MikeGrumbach/Arduino-RV-LED-Light-Controller/steps up to bedroom over LiON Batteries.jpg

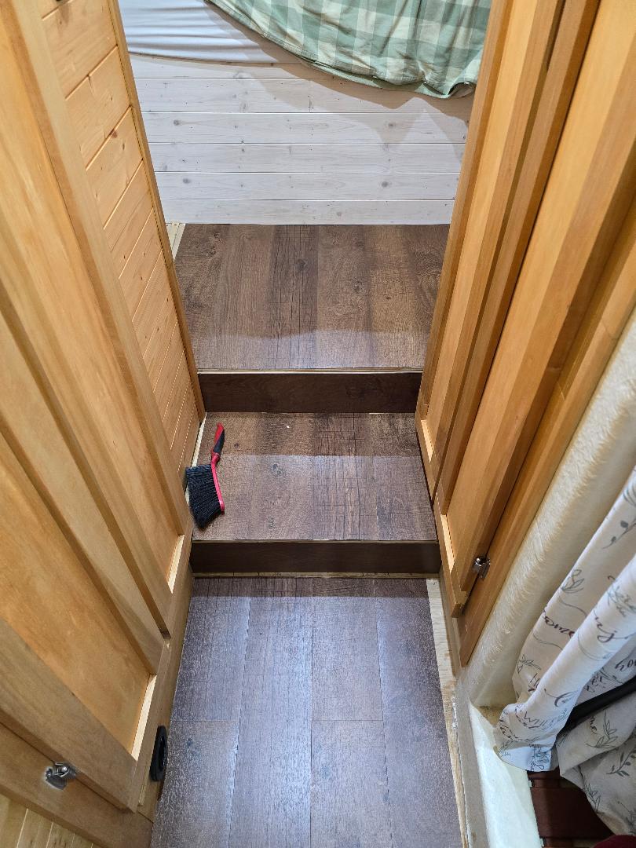
steps up to bedroom over LiON Batteries.jpg
