MikeGrumbach/Arduino-RV-LED-Light-Controller/toilet.jpg

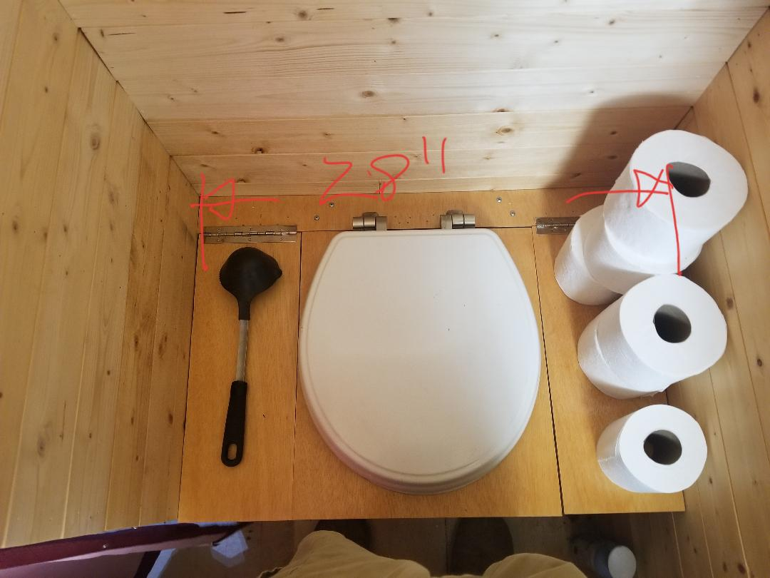
toilet.jpg
