MikeGrumbach/Arduino-RV-LED-Light-Controller/README.md

# Arduino-RV-LED-Light-Controller
This project is used to allow multiple 12v led ceiling lights, wired in parallel, to be turned off/on with a handheld IR controller and/or a wall switch, and Arduino Uno and a small electronic circuit
