MikeGrumbach/Arduino-RV-LED-Light-Controller/Arduino/README.md

**Arduino Code**

This folder contains the Arduino code for the RV LED Light Controller project.
