MikeGrumbach/Arduino-RV-LED-Light-Controller/Documentation/Arduino Software Requirements.pdf

This sketch was developed and tested using Arduino IDE 2.3.7, with the Arduino Uno and IRremote.h library.

If you are using a different version, some commands or functions may not be recognized by the compiler and the sketch may require modifications.

# Arduino Software Requirements

Saturday, September 5, 2026 12:30 PM

Light Switch Page 1
