MikeGrumbach/Arduino-RV-LED-Light-Controller/Resources/Helpful Links.pdf

Some helpful links I used when creating the circuit board
How to Build a Voltage Comparator Circuit with an LM393 (https://www.learningaboutelectronics.com/Articles/LM393-voltage-comparator-circuit.php)

LM358 IC Pin Configuration, Working, LM358 Circuit Examples (https://www.electroniclinic.com/lm358-ic-pin-configuration-working-lm358-circuit-examples/)

Op-amp Comparator Circuit Compares Voltage Levels (https://www.electronics-tutorials.ws/opamp/op-amp-comparator.html)

What is a Diode? A Guide For Beginners (https://www.build-electronic-circuits.com/what-is-a-diode/)

NPN Transistor Tutorial - The Bipolar NPN Transistor (https://www.electronics-tutorials.ws/transistor/tran_2.html)

Transistor as a Switch - Using Transistor Switching (https://www.electronics-tutorials.ws/transistor/tran_4.html)

# Helpful Links

Thursday, December 25, 2025 2:03 PM

Light Switch Page 1
