MikeGrumbach/Arduino-RV-LED-Light-Controller/Skoolie/bathroom and power closet.jpg

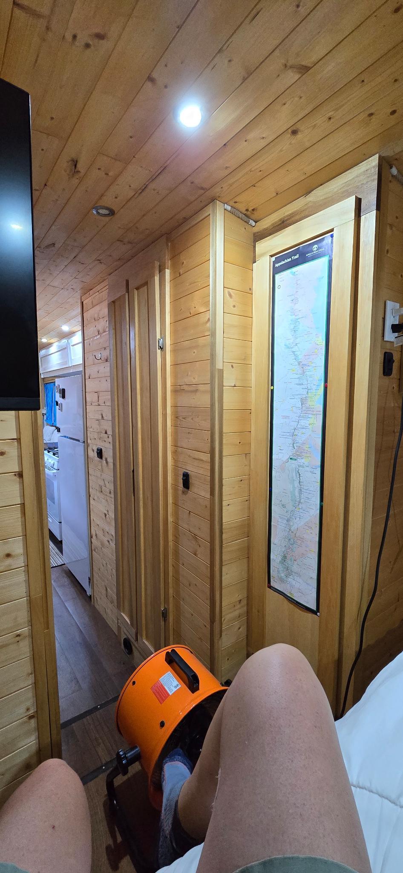
Skoolie/bathroom and power closet.jpg
