MikeGrumbach/Arduino-RV-LED-Light-Controller/Skoolie/bathroom sink.jpg

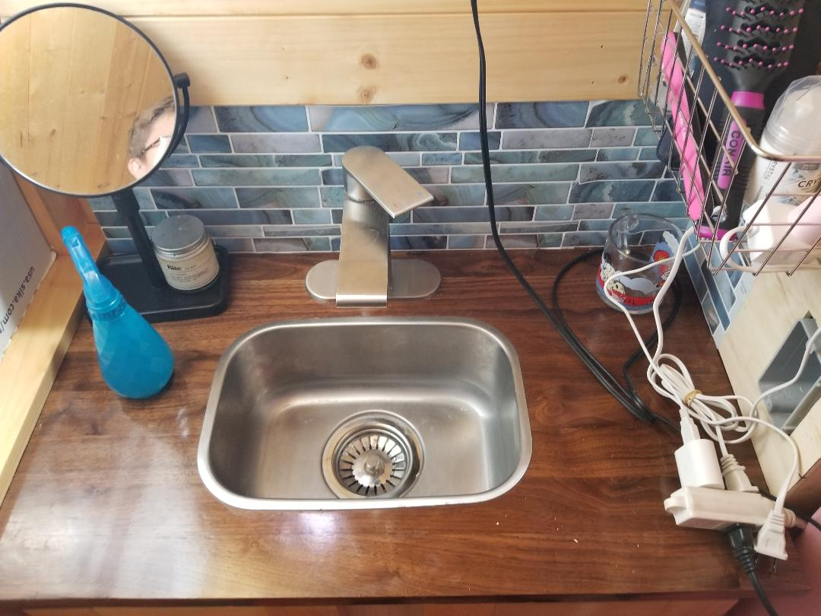
Skoolie/bathroom sink.jpg
