MikeGrumbach/Arduino-RV-LED-Light-Controller/Skoolie/bedroom clothes cabinet.jpg

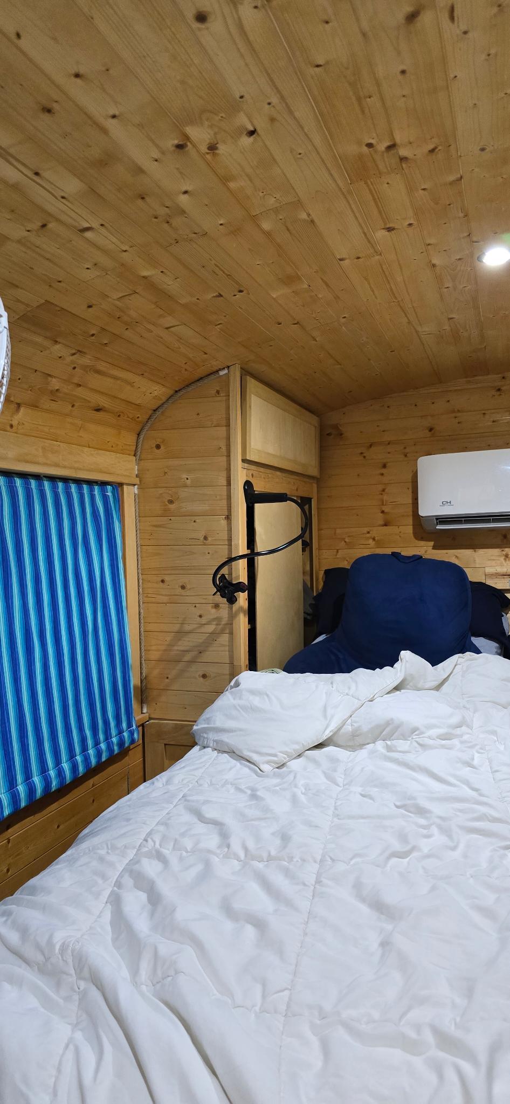
Skoolie/bedroom clothes cabinet.jpg
