MikeGrumbach/Arduino-RV-LED-Light-Controller/Skoolie/bedroom.jpg

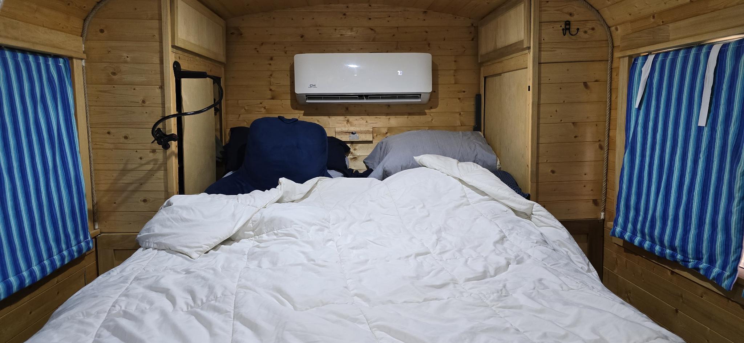
Skoolie/bedroom.jpg
