MikeGrumbach/Arduino-RV-LED-Light-Controller/Skoolie/closet.jpg

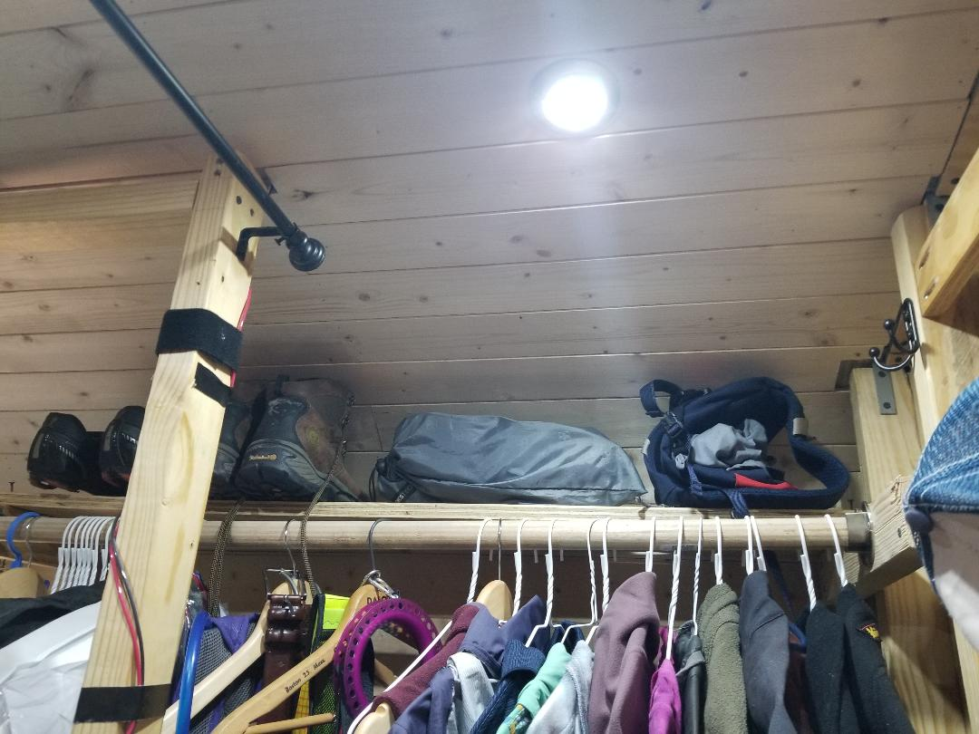
Skoolie/closet.jpg
