MikeGrumbach/Arduino-RV-LED-Light-Controller/Skoolie/collapsible table.jpg

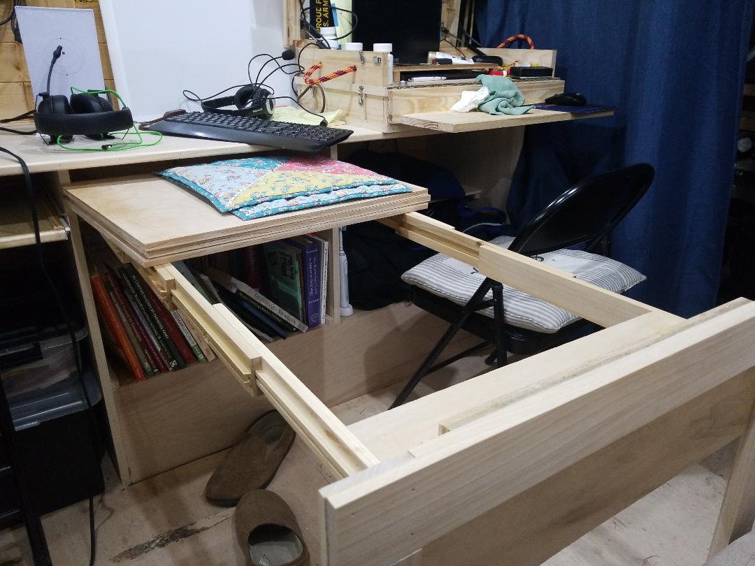
Skoolie/collapsible table.jpg
