MikeGrumbach/Arduino-RV-LED-Light-Controller/Skoolie/couch.jpg

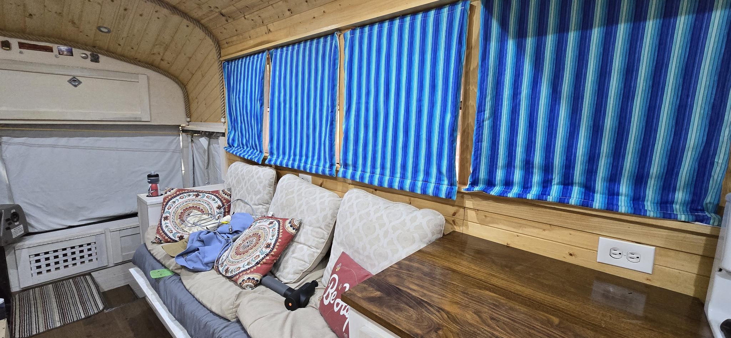
Skoolie/couch.jpg
