MikeGrumbach/Arduino-RV-LED-Light-Controller/Skoolie/flatscreen in bedroom.jpg

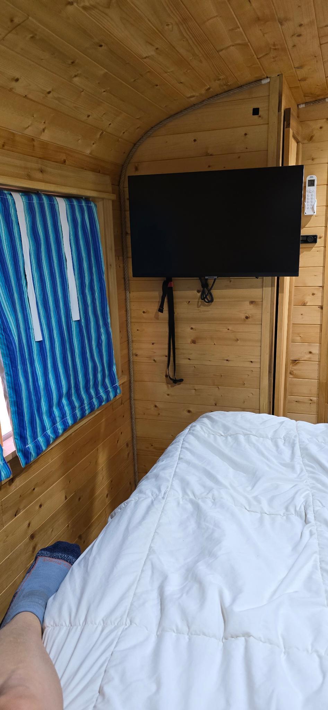
Skoolie/flatscreen in bedroom.jpg
