MikeGrumbach/Arduino-RV-LED-Light-Controller/Skoolie/front area.jpg

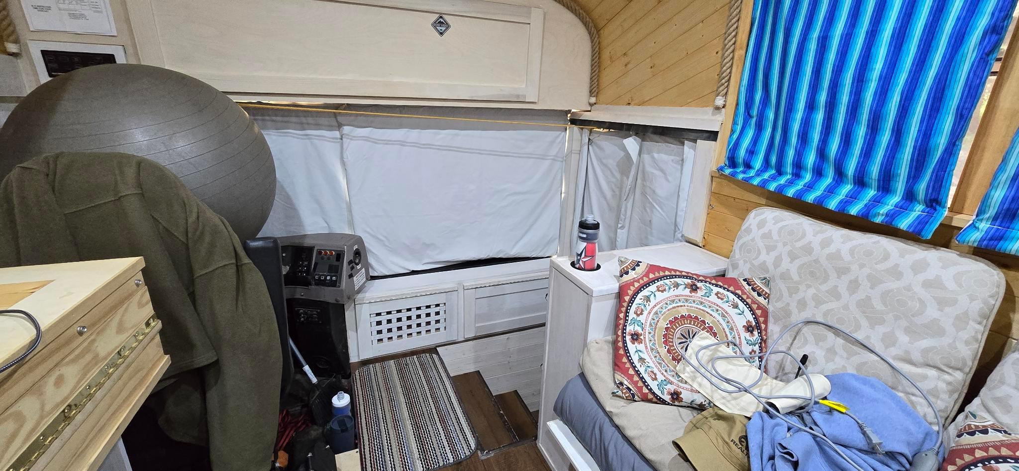
Skoolie/front area.jpg
