MikeGrumbach/Arduino-RV-LED-Light-Controller/Skoolie/front office.jpg

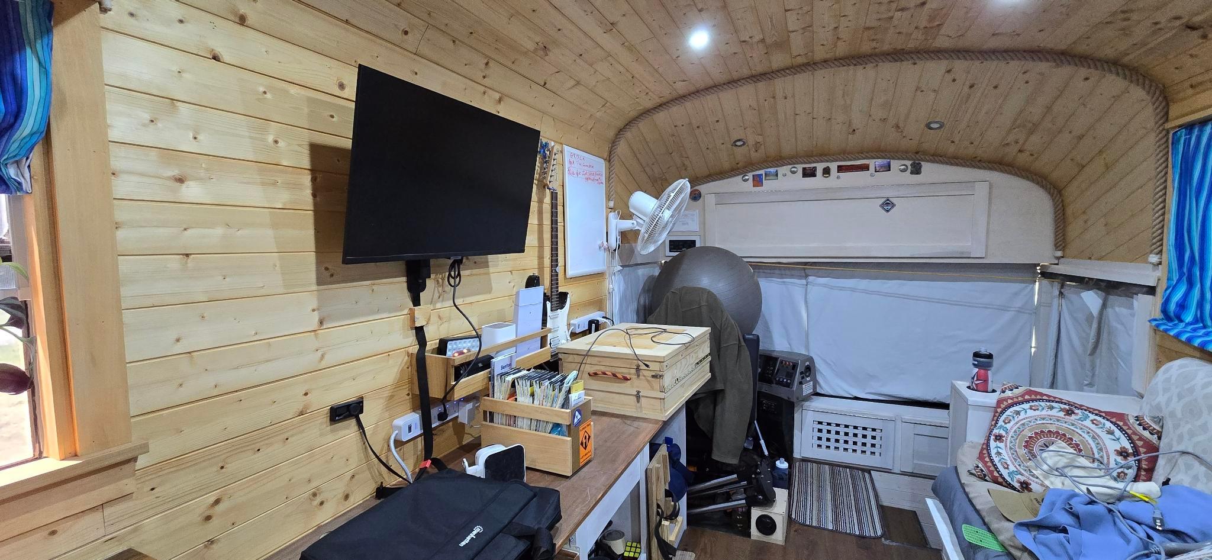
Skoolie/front office.jpg
