MikeGrumbach/Arduino-RV-LED-Light-Controller/Skoolie/galley 2.jpg

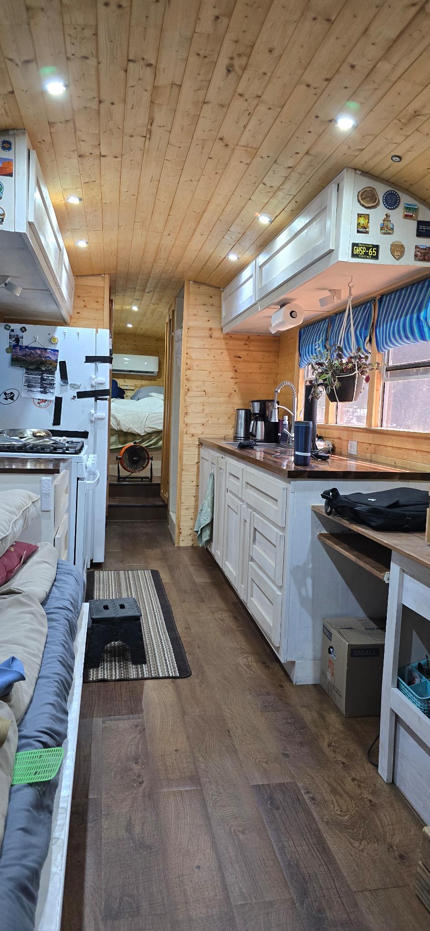
Skoolie/galley 2.jpg
