MikeGrumbach/Arduino-RV-LED-Light-Controller/Skoolie/galley.jpg

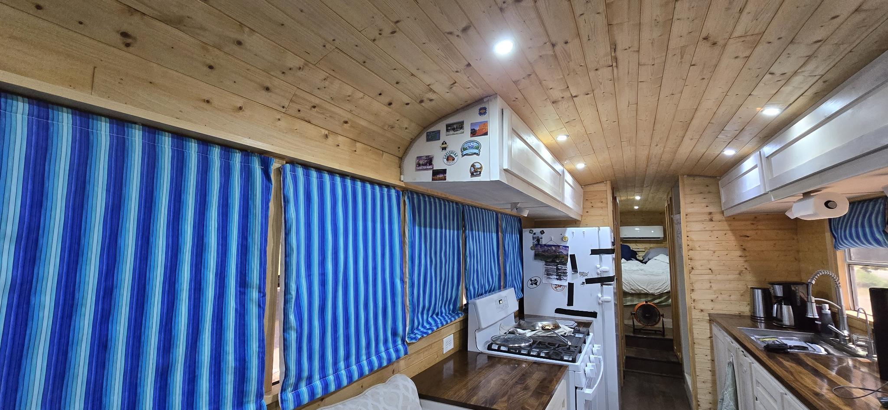
Skoolie/galley.jpg
