MikeGrumbach/Arduino-RV-LED-Light-Controller/Skoolie/kitchen drawers.jpg

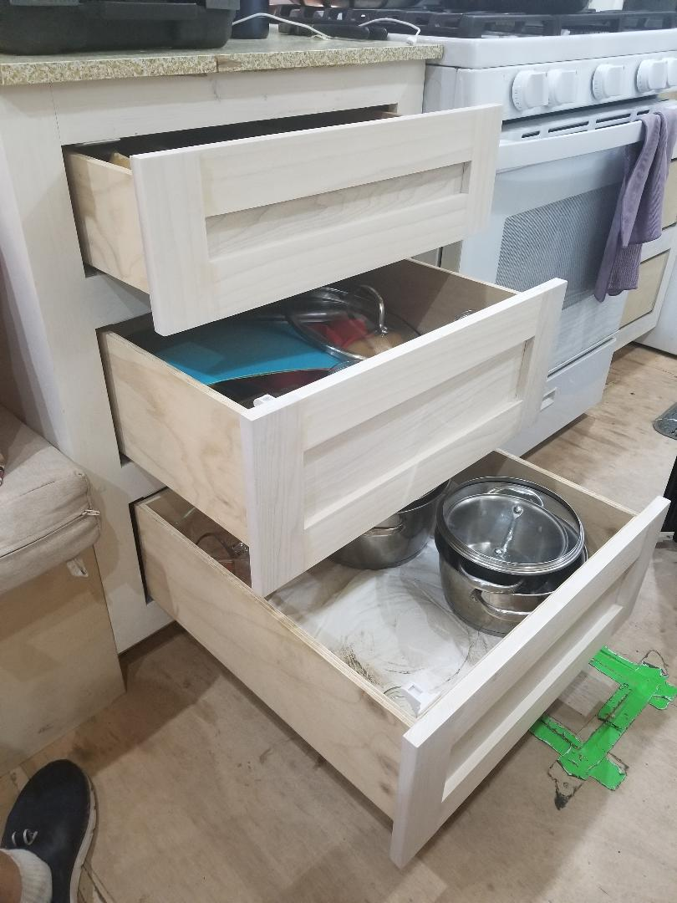
Skoolie/kitchen drawers.jpg
