MikeGrumbach/Arduino-RV-LED-Light-Controller/Skoolie/shower.jpg

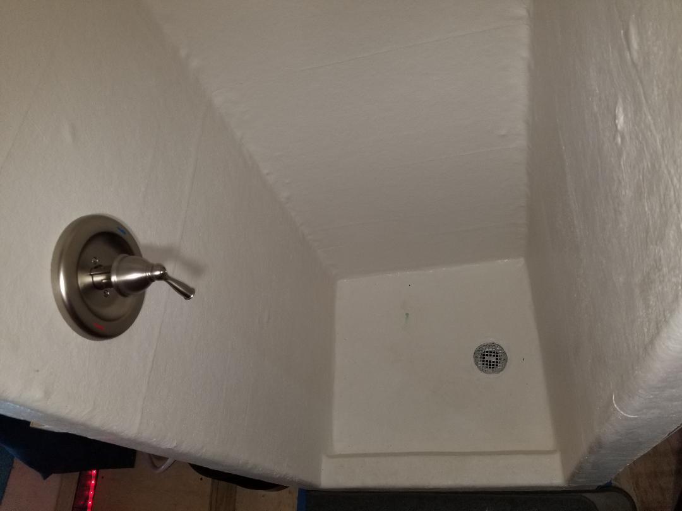
Skoolie/shower.jpg
