MikeGrumbach/Arduino-RV-LED-Light-Controller/starlink.jpg

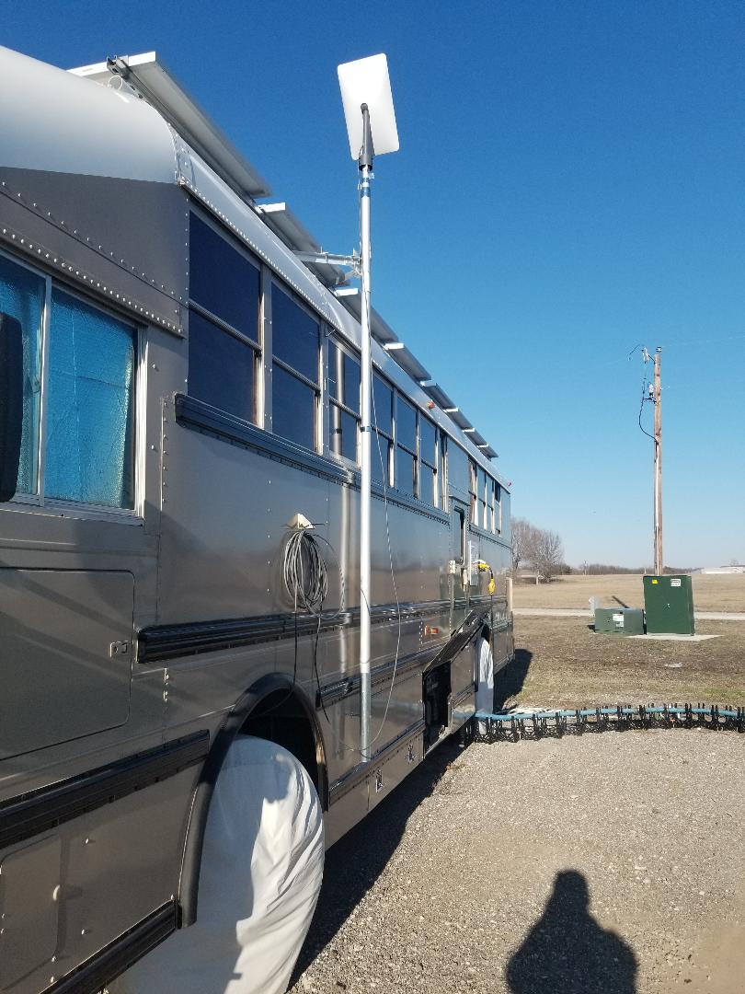
starlink.jpg
