MikeGrumbach/Arduino-RV-LED-Light-Controller/Schematic/Circuit Board Illustrations.pdf

# +12V ((1) Connected to “ceiling light power”)

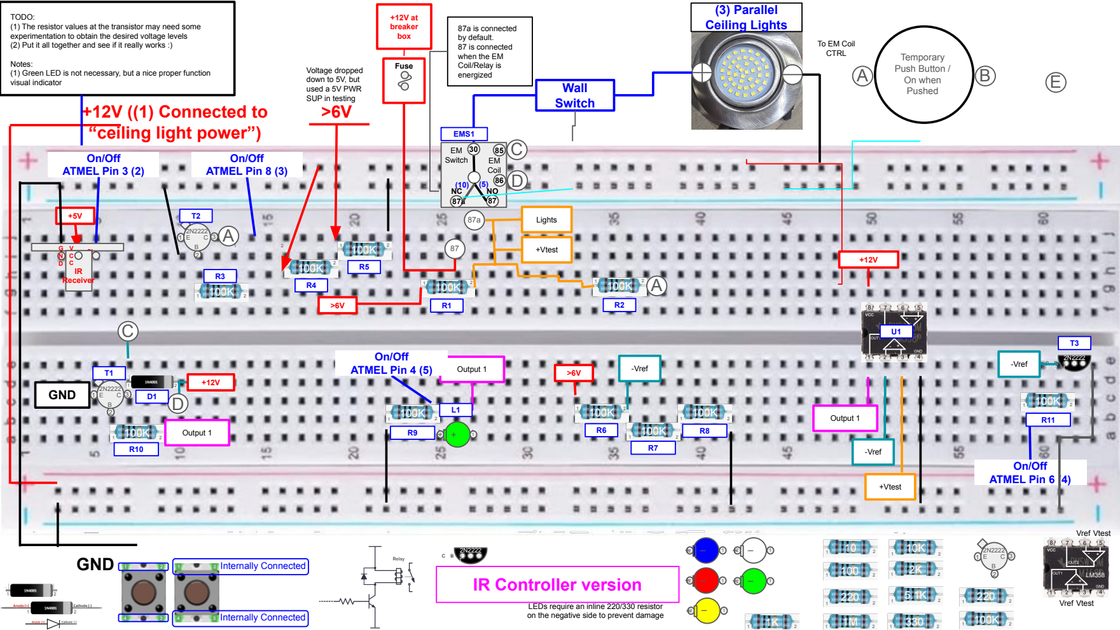
[picture p24: page 1]

TODO:
(1) The resistor values at the transistor may need some
experimentation to obtain the desired voltage levels
(2) Put it all together and see if it really works :)

Notes:
(1) Green LED is not necessary, but a nice proper function
visual indicator

LEDs require an inline 220/330 resistor
on the negative side to prevent damage

# +12V ((1) Connected to “ceiling light power”)

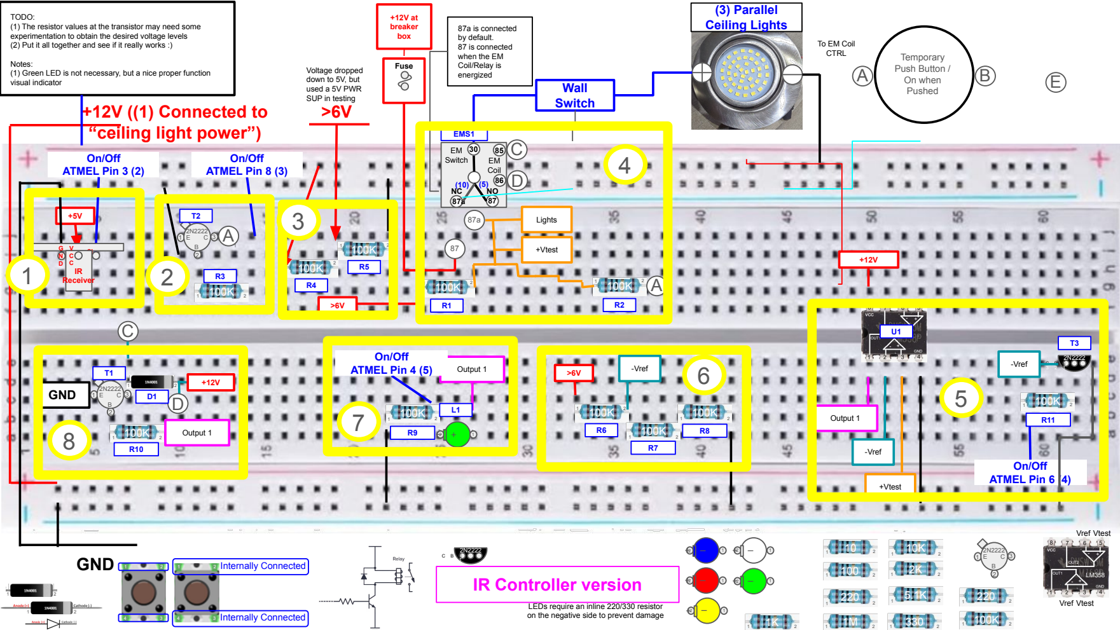
[picture p25: page 2]
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

Notes:
(1) Green LED is not necessary, but a nice proper function
visual indicator

LEDs require an inline 220/330 resistor
on the negative side to prevent damage

# +12V ((1) Connected to “ceiling light power”)

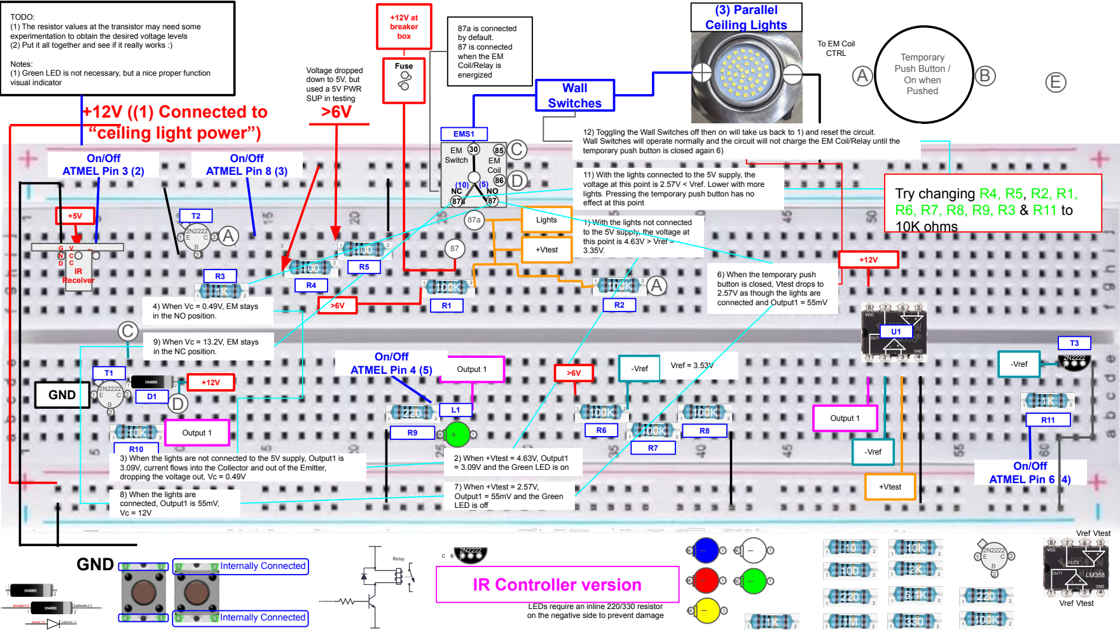
[picture p26: page 3]
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

Notes:
(1) Green LED is not necessary, but a nice proper function
visual indicator

12) Toggling the Wall Switches off then on will take us back to 1) and reset the circuit.
Wall Switches will operate normally and the circuit will not charge the EM Coil/Relay until the
temporary push button is closed again 6)

11) With the lights connected to the 5V supply, the
voltage at this point is 2.57V < Vref. Lower with more
lights. Pressing the temporary push button has no
effect at this point

1) With the lights not connected
to the 5V supply, the voltage at
this point is 4.63V > Vref =

6) When the temporary push
button is closed, Vtest drops to
2.57V as though the lights are
connected and Output1 = 55mV

4) When Vc = 0.49V, EM stays
in the NO position.

9) When Vc = 13.2V, EM stays
in the NC position.

3) When the lights are not connected to the 5V supply, Output1 is
3.09V, current flows into the Collector and out of the Emitter,
dropping the voltage out, Vc = 0.49V

2) When +Vtest = 4.63V, Output1
= 3.09V and the Green LED is on

8) When the lights are
connected, Output1 is 55mV,

LEDs require an inline 220/330 resistor
on the negative side to prevent damage

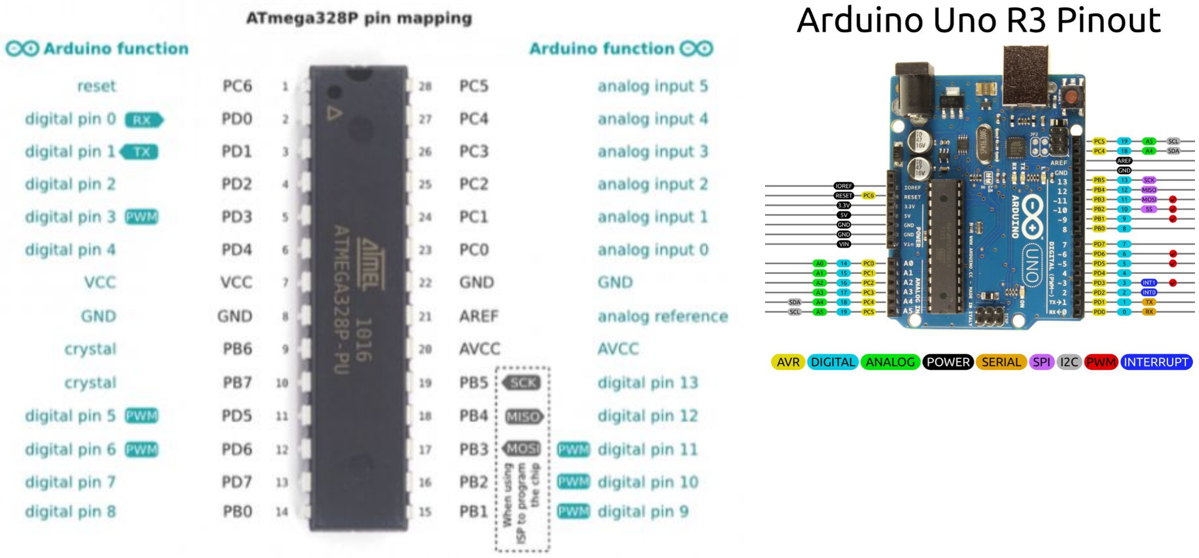
[picture p27: page 4]

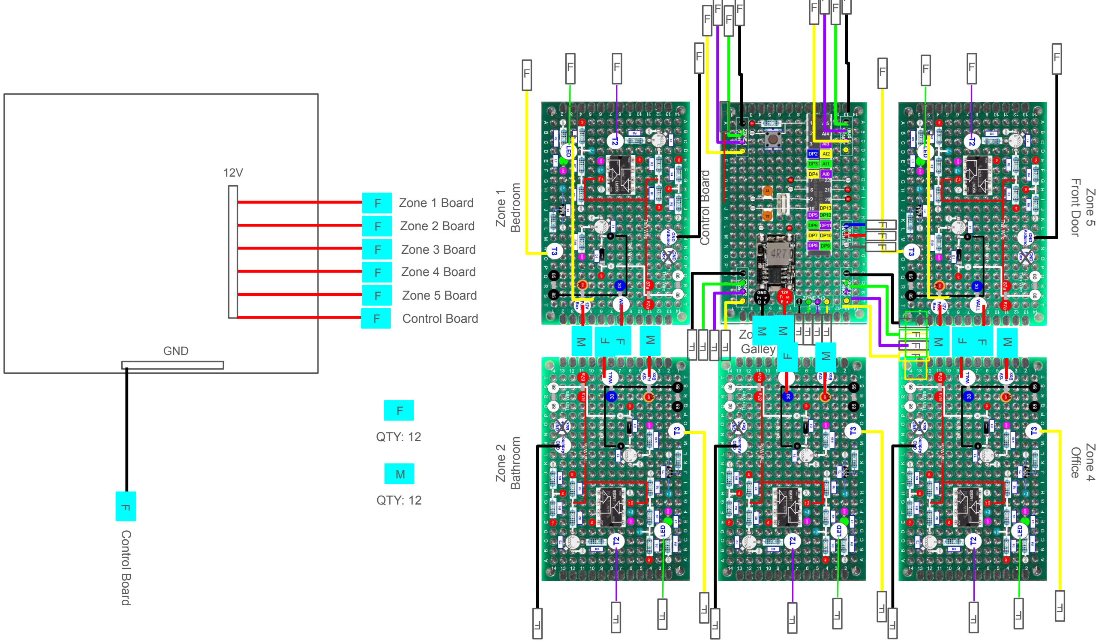
[picture p28: figure]
GND; FFFFF; Zone 1; Bedroom; Zone 2; Bathroom; Zone 3 Galley; Office; Zone 4 Zone 5; Front Door; Control Board; Zone 1 Board; Zone 2 Board; Zone 3 Board; Zone 4 Board; Zone 5 Board; QTY: 12 M; QTY: 12

M

M

M

M

M

## To 5 Light Zones

F
F

## Remember to tie the GND on the Microcontroller

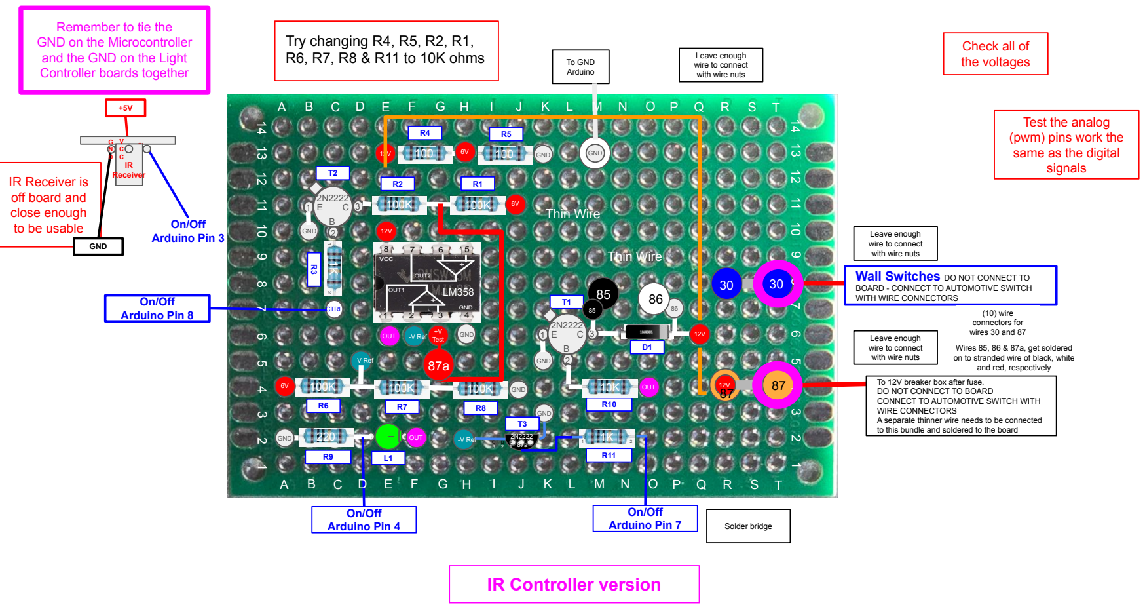
[picture p29: page 6]

and the GND on the Light
Controller boards together

Test the analog
(pwm) pins work the
same as the digital
signals

Leave enough
wire to connect
with wire nuts
Wall Switches DO NOT CONNECT TO

BOARD - CONNECT TO AUTOMOTIVE SWITCH
WITH WIRE CONNECTORS

Wires 85, 86 & 87a, get soldered
on to stranded wire of black, white

DO NOT CONNECT TO BOARD
CONNECT TO AUTOMOTIVE SWITCH WITH
WIRE CONNECTORS
A separate thinner wire needs to be connected
to this bundle and soldered to the board

10178
5V | 10K

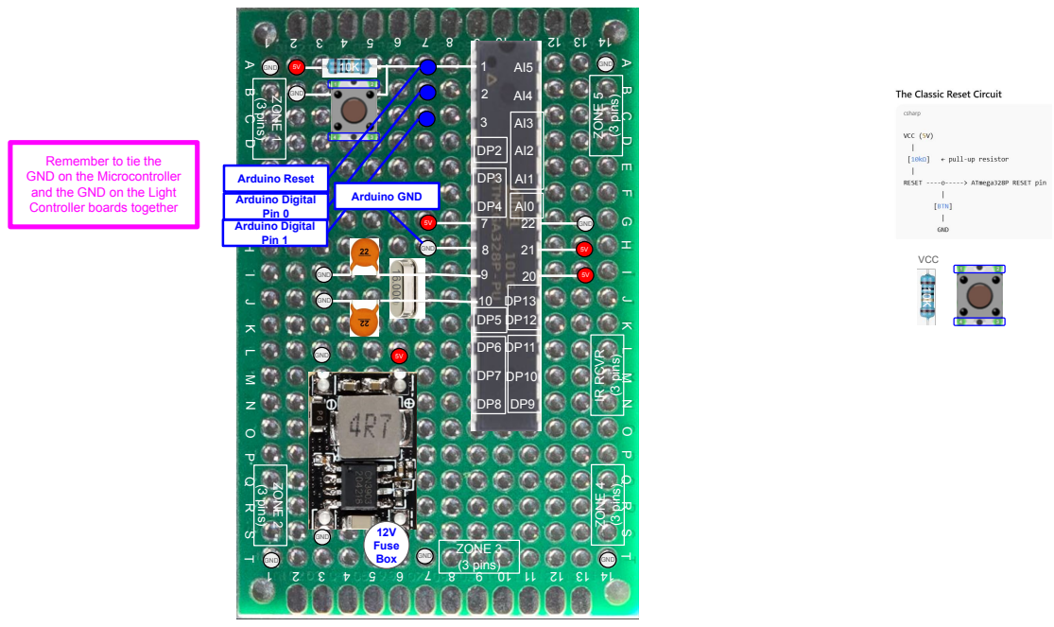
[picture p30: page 7]
10K VCC; GND; Arduino Reset; Arduino Digital Pin 1; Arduino Digital Pin 0; Arduino GND; 12V Fuse Box; (3 pins); ZONE 1; ZONE 2; ZONE 3 (3 pins); ZONE 4; ZONE 5; IR RCVR

GND

Remember to tie the
GND on the Microcontroller
and the GND on the Light
Controller boards together

1
5V | 10K

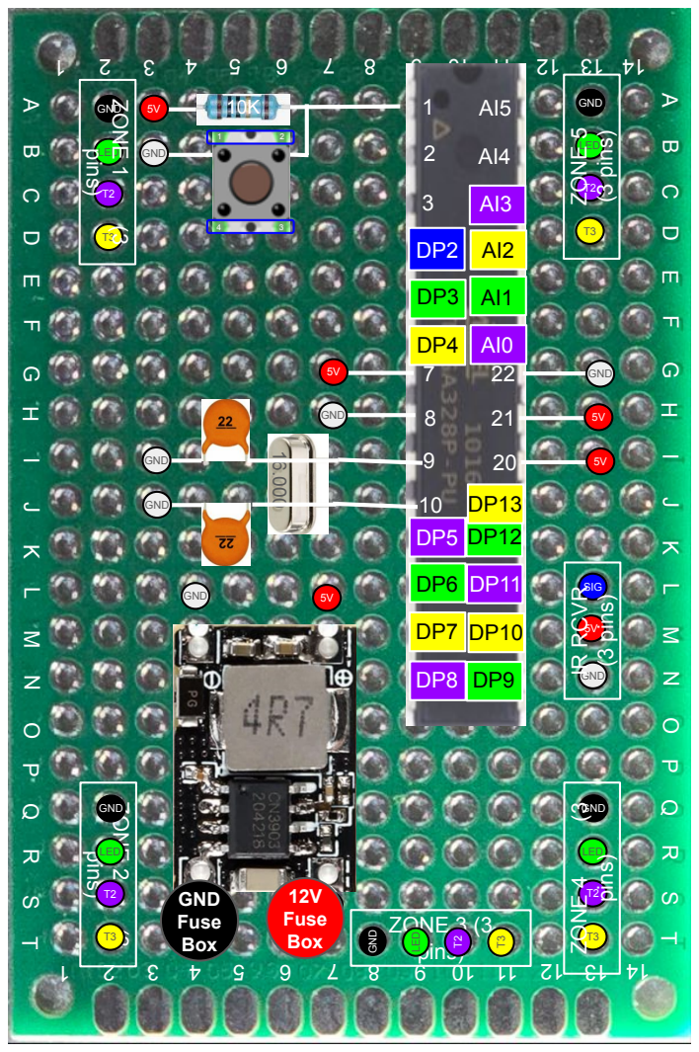
[picture p31: page 8]
GND; 12V Fuse Box; ZONE 2 (3; pins); ZONE 3 (3 pins); LED; ZONE 1 (3; T3ZONE ⁵ (3 pins⁾; ZONE 4 (3; GND Fuse Box

SIGIR RCVR (3 pins⁾

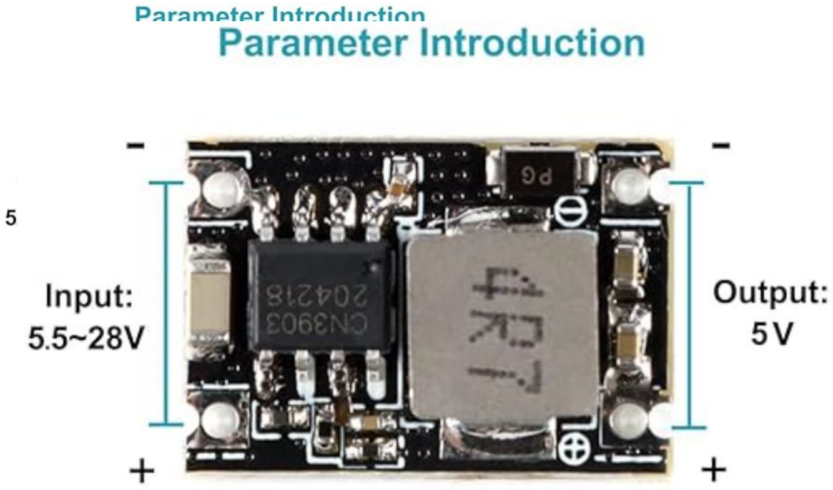
[picture p32: figure]

# Zone and Control Board wires terminate

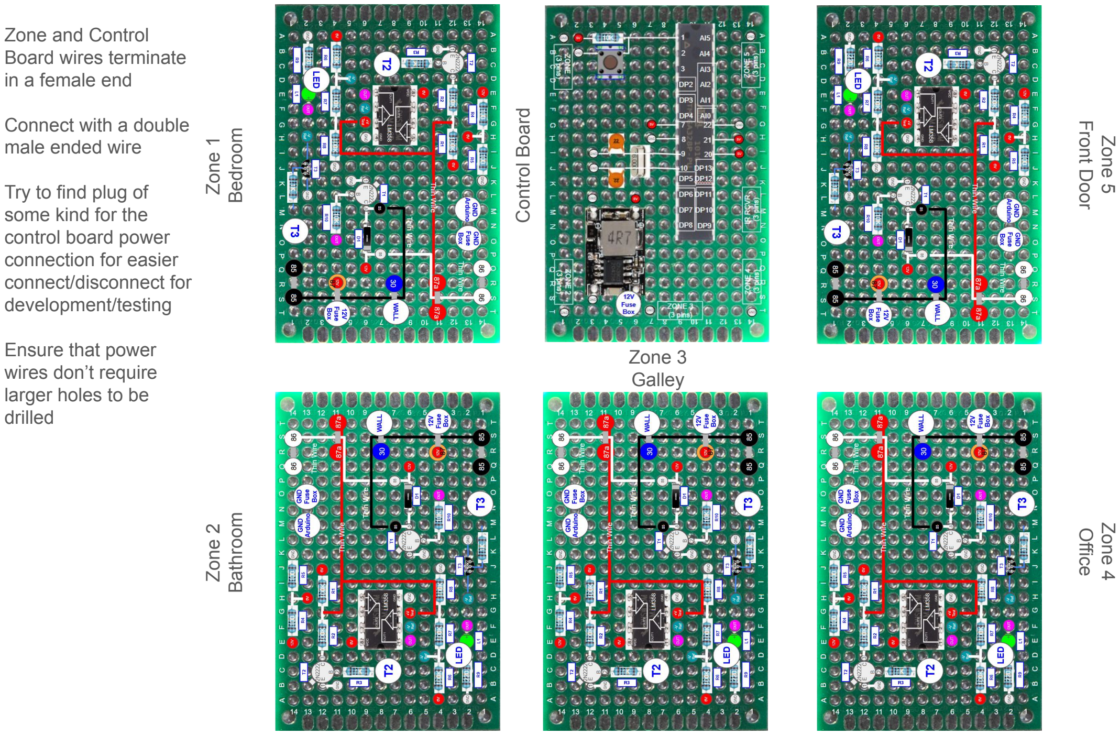
[picture p33: page 10]

# Zone 1

# Bedroom

# Zone 2

# Bathroom

# Zone 3 Galley

# Office

# Zone 4 Zone 5

# Front Door

# in a female end

# Connect with a double male ended wire

# Try to find plug of some kind for the control board power connection for easier connect/disconnect for development/testing

# Ensure that power wires don’t require larger holes to be drilled

# Control Board

6cm

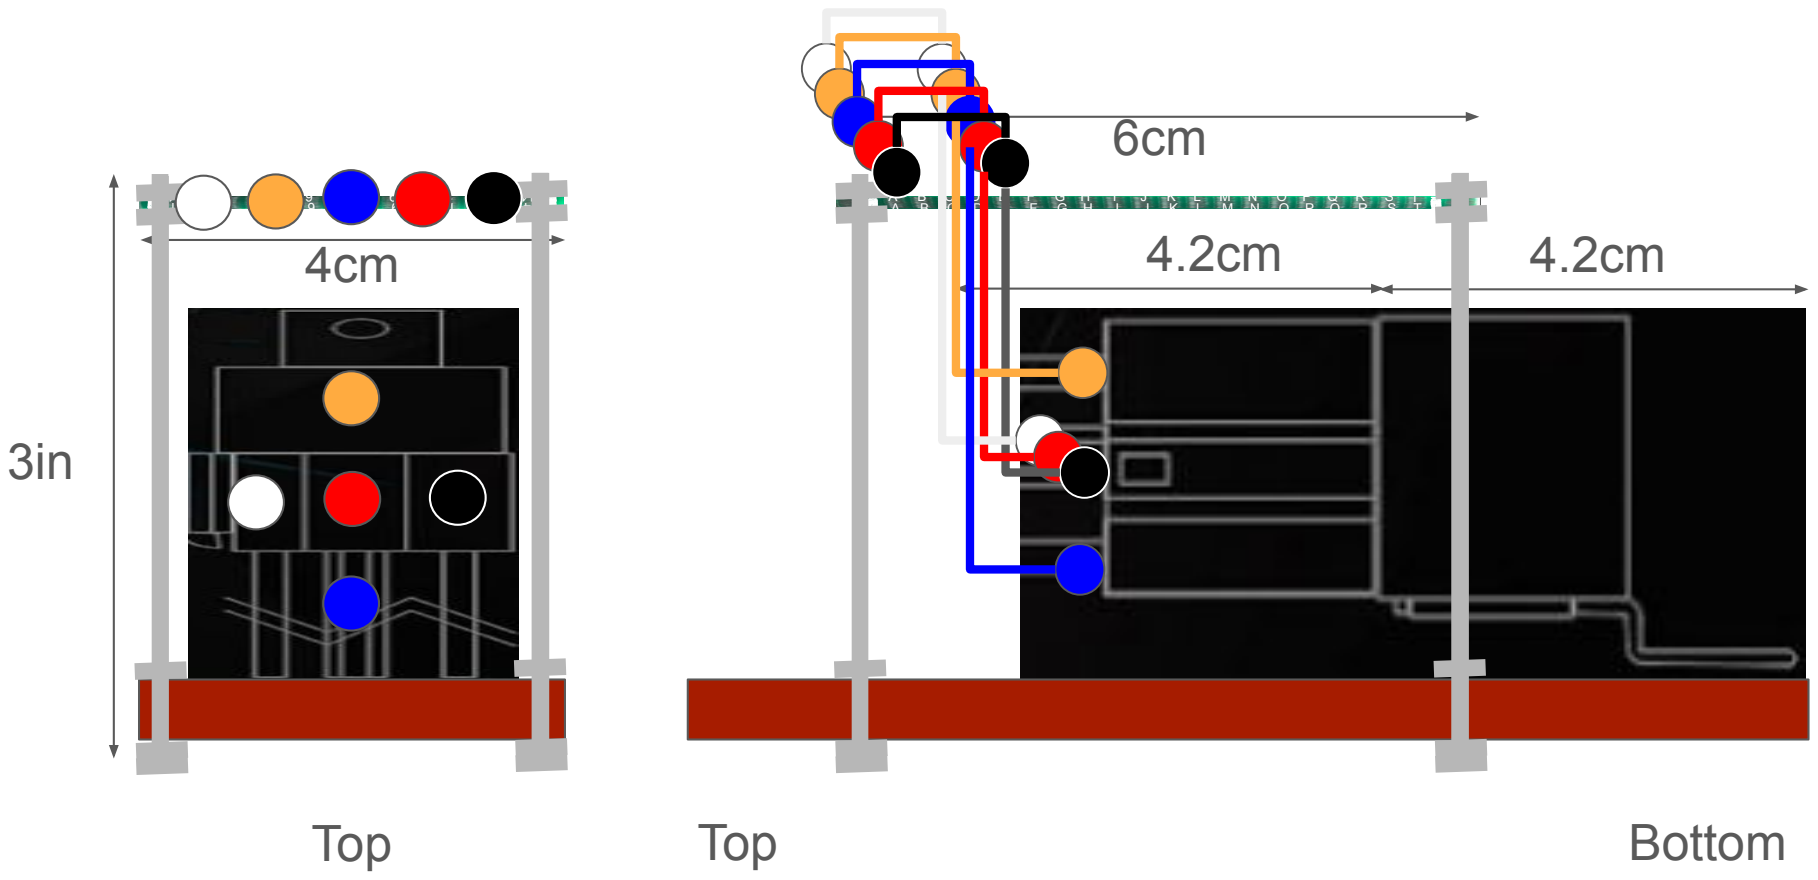
[picture p34: page 11]
THQPSACREBIGDKFMJOLN; Top; Bottom
