MikeGrumbach/Arduino-RV-LED-Light-Controller/Schematic/Circuit Board Pinout 1.pdf

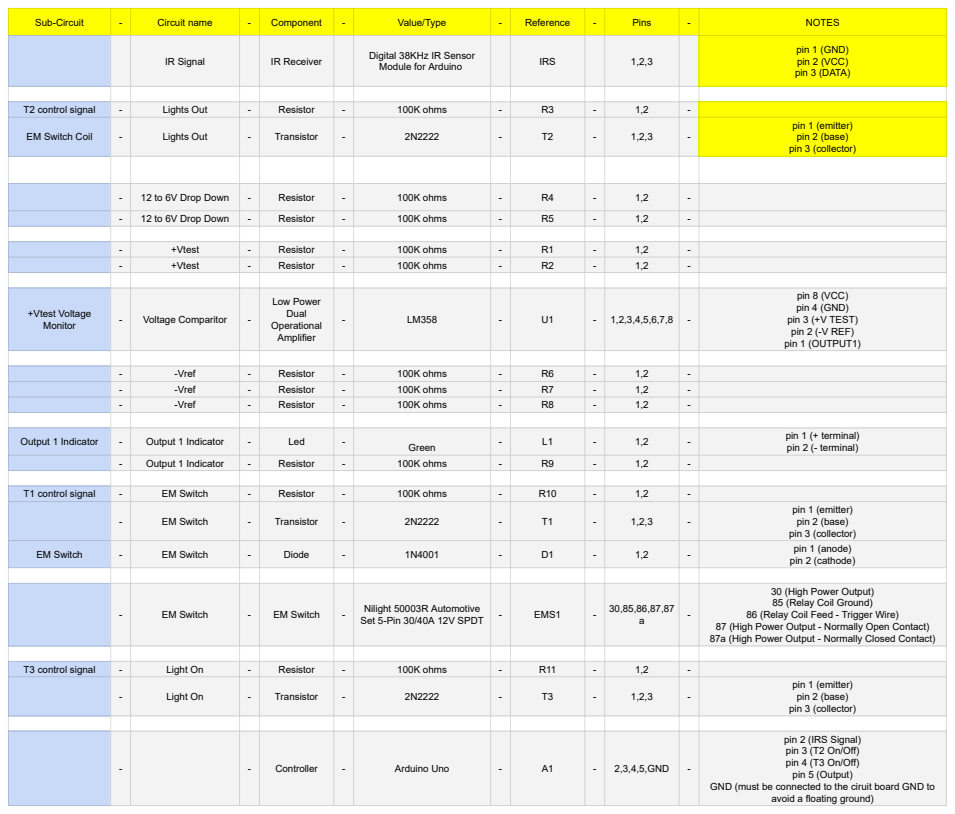
[picture p35: page 1]

Low Power Dual Operational Amplifier

30 (High Power Output)
85 (Relay Coil Ground)
86 (Relay Coil Feed - Trigger Wire)
87 (High Power Output - Normally Open Contact)
87a (High Power Output - Normally Closed Contact)

pin 5 (Output) GND (must be connected to the ciruit board GND to
