MikeGrumbach/Arduino-RV-LED-Light-Controller/(commit log)

2026-09-06 Add initial Arduino code
2026-09-06 Moved lights_simplified.ino to Arduino folder
2026-09-06 Add Circuit Board Step-by-Step Operations.pdf
2026-09-06 Moved Circuit Board Step-by-Step Operations.pdf to Documentation folder
2026-09-06 Add Circuit Board Description by Zones.pdf
2026-09-06 Add Arduino Software Requirements.pdf
2026-09-06 Add Circuit Board Pinout x.pdf
2026-09-06 Rename Circuit Board Pinout 1.pdf to Schematic/Circuit Board Pinout 1.pdf
2026-09-06 Rename Circuit Board Pinout 2.pdf to Schematic/Circuit Board Pinout 2.pdf
2026-09-06 Add Circuit Board Illustrations.pdf
2026-09-06 Rename bathroom and power closet.jpg to Skoolie/bathroom and power closet.jpg
